kante95/summer_lab/circuit/currentdriver.pdf

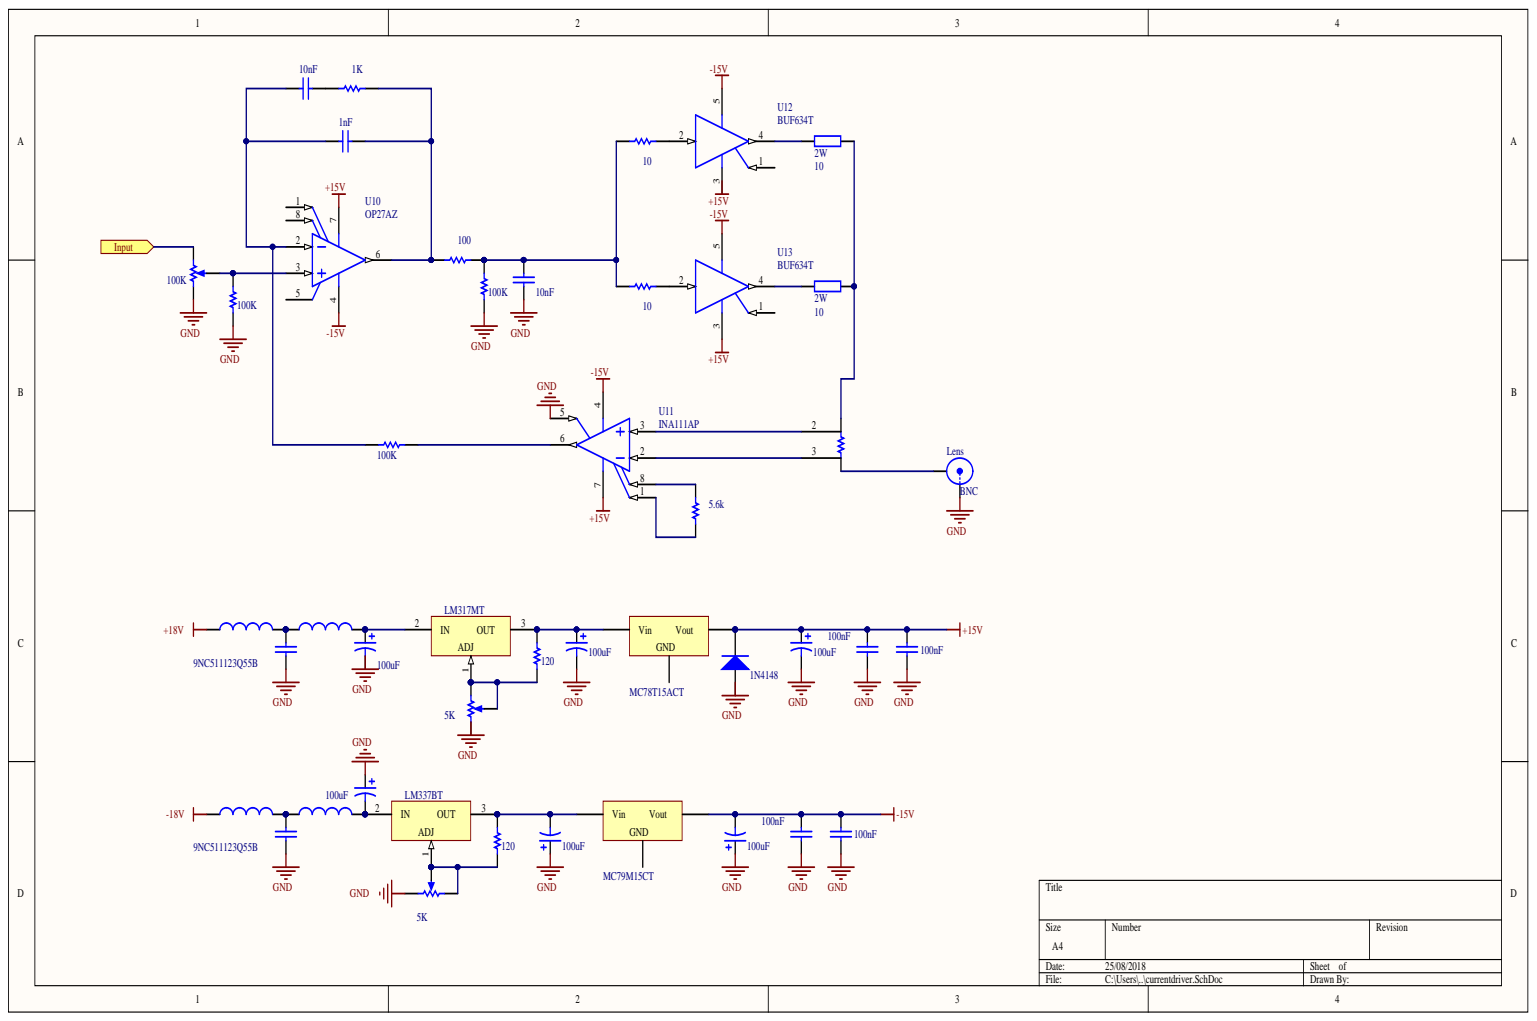
[picture p7: page 1]
