kante95/summer_lab/circuit/pid.pdf

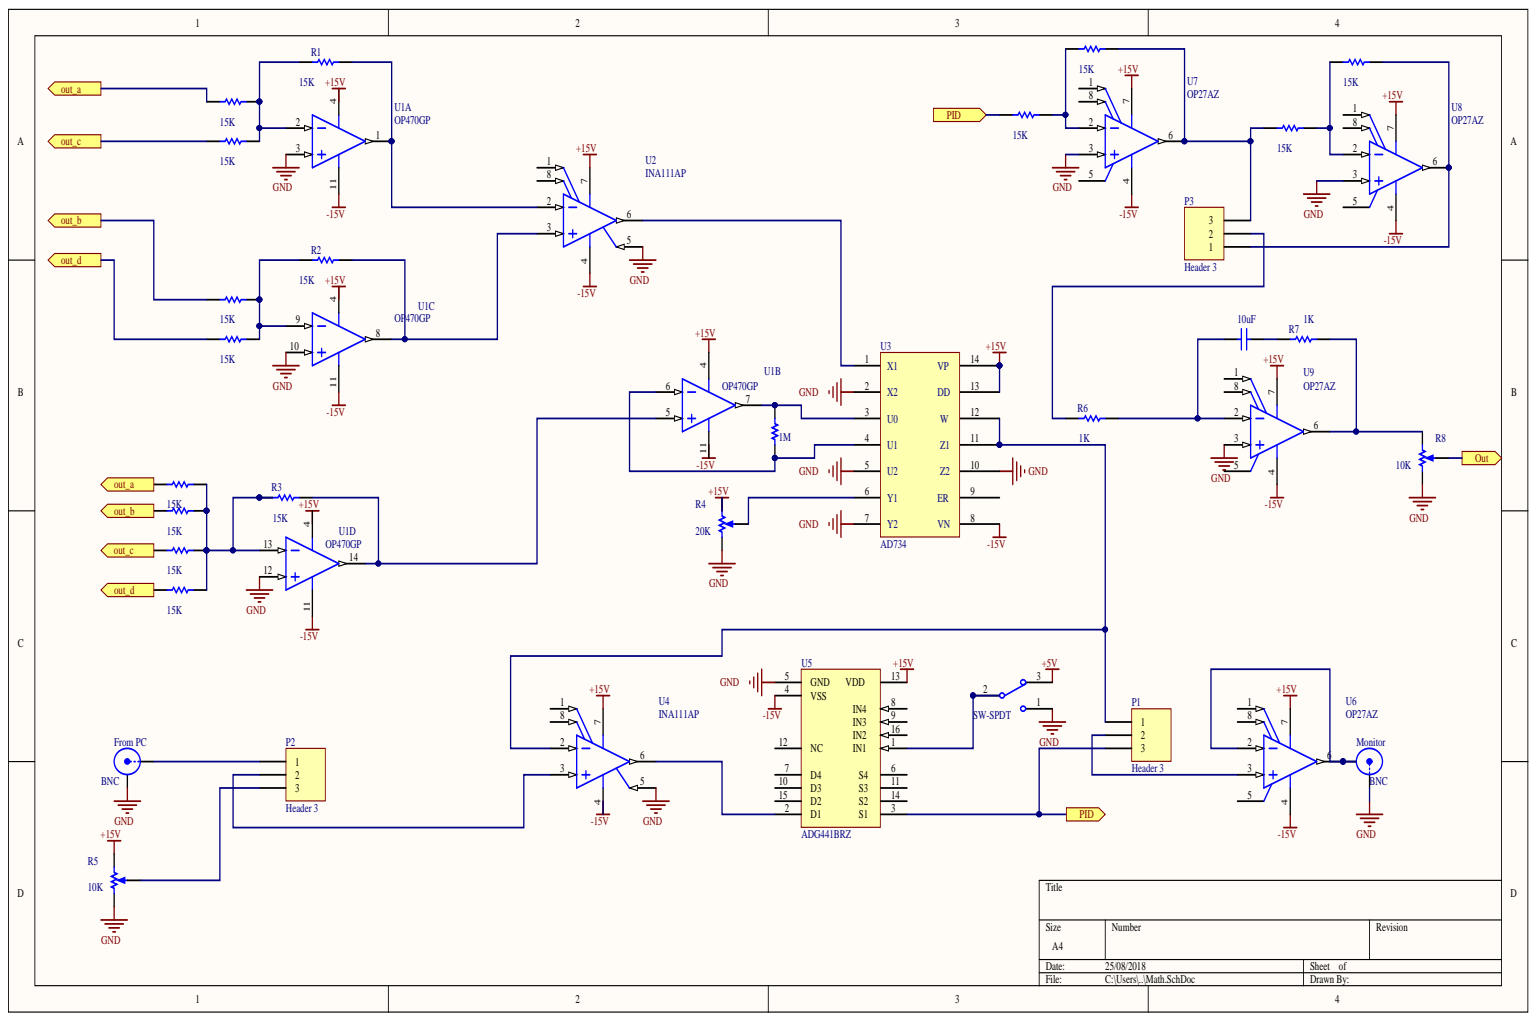
[picture p8: page 1]
