kante95/summer_lab/(list of files, drawings)

Other design files:
circuit/currentdriver.SchDoc
circuit/pid.SchDoc
