kante95/summer_lab/(commit log)

2018-08-25 circuits upload
    [currentdriver.SchDoc, pid.SchDoc]
2018-08-27 theory of tunable lens
